souvik-OOPS/SIH-2026/firmware/esp32_health_node/sensor_node.h

#pragma once

#include <DHT.h>
#include <MAX30105.h>

#include "config.h"
#include "telemetry_types.h"

class SensorNode {
 public:
  void begin();
  void update();
  TelemetryData snapshot(bool oledReady) const;

 private:
  void scanI2cBus();
  void beginMax30102();
  void beginMpu6050();
  void updateGas();
  void processPpgSample(uint32_t ir, uint32_t red);
  float readGravityMagnitude(uint8_t address);
  float readGyroMagnitude(uint8_t address);
  bool writeMpuRegisterRetrying(uint8_t address, uint8_t reg, uint8_t value);
  void updatePpg();
  void updateMotion();
  void updateDht22();
  void updateRain();
  void updateSignalQuality(uint32_t irValue);

  MAX30105 _max30102;
  DHT _dht{DHT_DATA_PIN, DHT22};

  bool _max30102Ready = false;
  bool _mpu6050Ready = false;
  uint32_t _lastImuProbeMs = 0;
  float _accelerometerLsbPerG = 4096.0f;
  float _gyroscopeLsbPerDps = 65.5f;
  uint32_t _lastImuMissWarnMs = 0;
  uint8_t _mpu6050Address = 0;
  bool _dht22Ready = false;

  uint32_t _lastPpgReadMs = 0;
  uint32_t _lastIrLogMs = 0;
  uint32_t _lastDhtReadMs = 0;
  uint32_t _lastRainReadMs = 0;
  uint32_t _lastMotionReadMs = 0;
  uint32_t _lastBeatMs = 0;
  uint32_t _lastRateMs = 0;
  uint32_t _lastPpgLogMs = 0;
  float _heartRateBpm = NAN;
  float _spo2Percent = NAN;
  bool _spo2Valid = false;
  bool _fingerPresent = false;
  uint8_t _signalQuality = 0;

  static constexpr uint8_t kSpo2BufferLength = 100;
  uint32_t _irBuffer[kSpo2BufferLength] = {0};
  uint32_t _redBuffer[kSpo2BufferLength] = {0};
  uint8_t _spo2BufferCount = 0;

  float _ambientTemperatureC = NAN;
  float _humidityPercent = NAN;
  float _accelerometerXG = NAN;
  float _accelerometerYG = NAN;
  float _accelerometerZG = NAN;
  float _gyroscopeXDps = NAN;
  float _gyroscopeYDps = NAN;
  float _gyroscopeZDps = NAN;

  /// Raw 12-bit ADC count, kept alongside the percentage so a miscalibrated
  /// board can be diagnosed from telemetry instead of by guesswork.
  int _rainRaw = -1;
  float _rainWetnessPercent = NAN;
  int _gasRaw = -1;
  float _gasIndex = NAN;
  uint32_t _lastGasReadMs = 0;
  uint32_t _lastGasLogMs = 0;
  bool _rainReady = false;
};
