souvik-OOPS/SIH-2026/(commit log)

2026-08-30 Initial commit: SIH26181 privacy-preserving health companion
    ESP32 wearable -> Node backend -> Nuxt 3 PWA prototype for Smart India
    Hackathon 2026 (PS SIH26181, Qualcomm).
    - backend/ Express + Socket.io ingest, rule-based anomaly detection,
    NOAA heat-index stress model, SMS escalation, Postgres/
    in-memory dual store
    - frontend/ Nuxt 3 offline-first PWA dashboard, history and alerts
    - ml/ BIDMC autoencoder training pipeline + JS inference parity test
    - firmware/ ESP32 sensor node with on-device fall detection, plus staged
    t1-t7 bring-up sketches
    - docs/ screenshots and generated README PDF
    Secrets (.env, config.h) are gitignored; .example templ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
    [bidmc_01_Numerics.csv, bidmc_02_Numerics.csv, bidmc_03_Numerics.csv, bidmc_04_Numerics.csv, bidmc_05_Numerics.csv, bidmc_06_Numerics.csv, bidmc_07_Numerics.csv, bidmc_08_Numerics.csv]
2026-09-01 Add Flutter mobile app: telemetry, BLE, SMS escalation, offline assistant
    Days 1-3 of the SIH26181 mobile build, plus the Day 2 BLE firmware and the
    offline AI assistant.
    Mobile app (health-companion/mobile):
    - TelemetrySource abstraction with replay and live-BLE implementations; the
    dashboard depends only on the contract, never on a concrete source.
    - Four deterministic replay fixtures (normal, heat warning, fall +
    non-response, bad signal) so the app demos with no hardware attached.
    - Signal tiers (GOOD/FAIR/POOR/REACQUIRING) and stale-data detection, both
    reported separately from a BLE disconnect.
    - Escalating reconnect backoff (4s -> 60s cap) to replace a fixed-interval
    scan tha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
    [ble_telemetry_service.cpp, ble_telemetry_service.h, buzzer_controller.cpp, buzzer_controller.h, config.example.h, esp32_health_node.ino, oled_status.cpp]
2026-09-01 Flatten repository layout and stop tracking docs
    Moves everything from health-companion/ to the repository root, so backend/,
    frontend/, mobile/, firmware/ and ml/ sit at the top level and README.md is
    the repository's front page. Git recorded these as renames, so file history
    is preserved.
    Stops tracking docs/. It holds generated PDFs and screenshots that are kept
    locally instead of published.
    Two consequences of dropping docs/ from the repository:
    - firmware/esp32_health_node/README.md links to ../../docs/ble_protocol.md.
    The relative path still resolves locally (the directory depth did not
    change), but the target is no longer in the repository, so the link is
    dead for anyone who c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
    [bidmc_01_Numerics.csv, bidmc_02_Numerics.csv, bidmc_03_Numerics.csv, bidmc_04_Numerics.csv, bidmc_05_Numerics.csv, bidmc_06_Numerics.csv, bidmc_07_Numerics.csv, bidmc_08_Numerics.csv]
2026-09-02 Personalise heart-rate rules by age and learned resting baseline
    Adds the two personalisation mechanisms that the dataset can actually support,
    both deterministic. A conditional model over demographics was considered and
    rejected: BIDMC carries no age, sex, height or weight, and 53 subjects cannot
    teach a network what is normal for a cohort without memorising individuals.
    Age tightens the heart-rate ceiling to 70% of Tanaka's maximum
    (208 - 0.7 x age), clamped to 95-140 bpm. Tanaka rather than 220 - age, which
    underestimates maximum heart rate in older adults - the group this project
    targets. Age may only tighten, never raise: a sustained 120 bpm at rest is
    worth flagging at any age, and re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
2026-09-02 Add the offline safety loop: fall detection, risk engine, non-response, packet
    Completes the local pipeline from telemetry to an emergency summary with no
    network involved at any step. Also fills the gap Day 4-6 left: there was no
    risk engine anywhere in the repo, only the placeholder card promising one.
    Fall detection walks a state machine rather than thresholding one spike, since
    a spike alone cannot separate a fall from setting the device down hard:
    free fall (optional) -> impact -> orientation change -> stillness
    Free fall and orientation are corroborating, not required. A fall from sitting
    barely registers free fall, and a wrist-worn device can land oriented much as
    it started, so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
2026-09-02 Add the fall check-in overlay and the privacy screen
    Makes the offline safety loop something a person can drive, rather than
    something only curl could reach. Both screens work with no internet.
    The check-in overlay lives in the layout rather than on the dashboard, so a
    fall surfaces wherever the wearer happens to be looking. It is deliberately
    blocking and full-screen: everything else on this app is information, and this
    is the one thing that asks the wearer to act.
    Its countdown is polled on its own clock rather than driven by incoming
    readings. The whole point of the countdown is the case where the wearer has
    stopped moving and telemetry may have stopped with them, so a timer that only
    a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
2026-09-02 Document the 25 env vars added in Days 7 and 8
    .env.example covered 16 of the 41 variables config.js actually reads, so a
    fresh clone had no way to discover the fall thresholds, the disaster feed
    settings or the alert timings without reading the source.
    Verified that dotenv strips the inline comments: every documented value parses
    to the right type rather than to a string with a comment glued to it.
2026-09-02 Add risk engine, signal-quality rework and the themed dashboard
    This commit carries work from two agents running in parallel on this repo,
    recorded together because the two touched the same files and cannot be
    separated after the fact without a broken intermediate state.
    From Codex: a RiskEngine with its config and tests, a telemetry parser,
    SensorTrustState and FallWorkflowState in the safety assessment, and
    SignalTier reworked into a five-level SignalQualityLevel. The dashboard now
    shows a real risk verdict instead of the "Awaiting Day 4-6 engine"
    placeholder.
    From this session: a theme system in core/theme/app_theme.dart, built from a
    Figma token set designed for a projected demo.
    The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
2026-09-02 Wire the rain board and the two-pin buzzer, and harden the BLE link
    Rain board reads on GPIO 34. The pin is not arbitrary: ADC2, which covers
    GPIO 0, 2, 4, 12-15 and 25-27, shares hardware with the radio and returns
    garbage whenever BLE is active, which for this firmware is always. GPIO 34 sits
    on ADC1 and is input-only, so it also cannot be driven by mistake. Eight
    samples are averaged per read because the ESP32 ADC is noisy, and the front end
    is set to 11 dB so the board's full 0-3.3 V swing is visible rather than
    clipping above ~1.1 V.
    Telemetry carries both the wetness percentage and the raw ADC count. The raw
    count is what makes a fault diagnosable: an unplugged board floats at some
    mi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
    [ble_telemetry_service.cpp, buzzer_controller.cpp, buzzer_controller.h, sensor_node.cpp, sensor_node.h, telemetry_types.h]
2026-09-04 Stop the BLE link killing itself, and identify the IMU by behaviour
    Two BLE bugs, both mine from the Day 3 reconnect work, found by reading
    logcat off the phone rather than by reasoning about the code.
    The link was killing its own connection. _handleDisconnect called
    device.disconnect() on a device that had already dropped. flutter_blue_plus
    queues that request behind a 2 s "disconnect gap", and the queued disconnect
    then tears down the NEXT connection about 1.5 s after it establishes. That
    loops forever: connect, killed, retry, killed. The logs showed it twice with
    near-identical delays of 1458 ms and 1462 ms, which is what gave it away -
    a race would not be that repeatable. Now only a dev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
    [sensor_node.cpp, sensor_node.h]
2026-09-04 Make the pulse sensor detectable, and print the IR count it is judged on
    Heart rate and SpO2 were permanently null with the sensor working. The
    telemetry showed f:0 and q:0 on every packet, which is the firmware correctly
    refusing to invent vitals with no finger detected - so the fault was in
    detection, not in the algorithms.
    Two causes, both starving it.
    LED brightness was 60 of 255, roughly 6 mA of drive. Through a fingertip that
    returns an IR count well under the 50000 contact threshold, so a finger that
    is genuinely present never registers. Raised to 0x7F, which costs battery and
    is what makes contact detectable at all.
    The FIFO averages every four conversions, so its output rate is t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
    [sensor_node.cpp, sensor_node.h]
2026-09-04 Fix the saturated pulse sensor and stop the IMU check failing closed
    Flashing the previous commit and reading the serial output showed both of its
    changes were wrong, in opposite directions.
    The pulse sensor now rails. Raising the LED to 0x7F without raising the
    photodiode range left the count pinned at 262143, the top of the 18-bit ADC.
    A railed signal is flat, and a flat signal has no pulsatile component, so no
    heartbeat can be found in it however long a finger rests there - the same null
    heart rate as before, arrived at from the other side. The ADC range moves to
    16384 to give the brighter LED somewhere to go, and becomes a config value
    since it has to track the brightness. Saturation is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
    [sensor_node.cpp]
2026-09-04 Let the IMU come back without a reflash, and flash at a baud this board survives
    The IMU was probed once, in begin(). A module that was unplugged, or whose
    3V3 rail sagged as the rain board and buzzer were added to it, therefore
    stayed null until the board was reflashed -- so the wiring could be repaired
    with the firmware still reporting nothing, which sends the search into
    software that is working correctly.
    updateMotion() now re-probes every 5 s while no IMU is present, and drops a
    part that stops answering back into probing rather than silently returning
    stale nulls. Reseating a wire is now enough to bring motion back.
    Uploads had failed on every attempt with "Wrong boot mode detected (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
    [sensor_node.cpp, sensor_node.h]
2026-09-04 Stop discarding the computed heart rate, and stop nulling it a line later
    With a finger on the sensor the optical side is healthy - IR reads about
    123000 against a 50000 contact threshold, nowhere near the 262143 rail - and
    yet hr stayed null. Three faults in the same function, each sufficient alone.
    maxim_heart_rate_and_oxygen_saturation() reports a heart rate beside SpO2.
    Both output arguments were passed, filled in, and never read. The rate came
    only from checkForBeat().
    checkForBeat() cannot carry it alone. It accepts a pulse only when the AC
    amplitude falls between 20 and 1000 counts, and through a fingertip at
    MAX30102_LED_BRIGHTNESS 0x7F the swing runs past that ceiling, so every be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
2026-09-04 Stop reporting gravity as movement on the dashboard
    The motion card printed the raw accelerometer magnitude, which is not a
    motion reading. An accelerometer at rest measures one gravity, so a band
    lying perfectly still on a table reported "Motion 1.00 g" - a number that
    reads as movement to anyone looking at it, and never falls to zero however
    still the wearer is.
    Subtract gravity and the figure sits near zero when nothing is happening,
    which is what the card was always meant to convey. The number is still shown
    next to a plain state - Still, Light movement, Active - so the reading stays
    inspectable rather than becoming a bare label.
2026-09-05 Describe movement on the motion card, and stop captioning it with the pulse sensor
    Two faults on the same row.
    It read "Motion -- g". A figure in g is not something anyone reads at a
    glance, and it is the wrong quantity besides: an accelerometer at rest
    measures one gravity, so the number never falls to zero however still the
    wearer is. The row now names what the wearer is doing - Still, Light
    movement, Heavy movement - which is the question the card exists to answer.
    Beside it sat "No finger contact". That is the MAX30102's contact state,
    printed against a reading that comes from the IMU: one sensor's status
    captioning another sensor's measurement, so a perfectly good movement level
    appea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
2026-09-05 Throttle the missing-IMU warning to once every 30 s
    The probe runs every 5 s, and each miss printed a full line. With the IMU
    unplugged the serial log became one sentence repeated twelve times a minute,
    burying the [ppg] and [hr] lines between them - and an unreadable log is how
    the earlier heart-rate faults stayed hidden for as long as they did.
    [sensor_node.cpp, sensor_node.h]
2026-09-05 Filter sensor jitter before scoring, so the model stops calling healthy readings anomalous
    The model was working on paper and failing in practice. JS/numpy parity held
    to 1e-8 and test AUC was 0.807, but fed live demo traffic it flagged 60% of
    readings as anomalous - including HR 73 / SpO2 98, which is textbook normal,
    at 18x the anomaly threshold.
    The cause is a train/serve mismatch in signal smoothness, not in values. In
    the BIDMC numerics the model was trained on, SpO2 is flat between 95.7% of
    consecutive samples and HR between 72.2%, so the autoencoder effectively
    learned that these vitals do not move inside a 30 second window. A real
    MAX30102 and the simulator both emit integers that f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
2026-09-05 Run the learned model on the phone, so it works with no network
    The companion's claim is privacy-preserving monitoring that keeps working
    offline, but the autoencoder only ever ran in the backend and fed the Nuxt
    PWA. The Flutter app - the one being demonstrated - contained no reference to
    it at all and scored risk from rules alone, so the AI half of the pitch was
    not present where anyone would look for it, and it needed a server besides.
    Inference is now a Dart port of anomalyModel.js, reading the same
    assets/ml/model.json. The network is a 4-layer MLP of about 4k parameters, so
    the forward pass is plain arithmetic - no plugin, no native library, no
    download - and 102 KB of weights ship in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
2026-09-05 Stop the model scoring readings the app already distrusts
    Replaying the bundled demo fixtures through the on-device detector showed it
    behaving correctly on three of four, and badly wrong on the fourth:
    normal median ratio 0.08 0/61 past the alert gate
    heat_warning median ratio 9.76 61/61 past it
    fall_nonresponse median ratio 0.49 0/61 (motion event, HR+SpO2 only)
    bad_signal median ratio 191.86 17/17 past it
    bad_signal is not a sick wearer. It is a sensor losing its grip: 7-38%
    confidence, contact flickering on and off, and HR stepping 74 -> 126 -> 49 ->
    151 between consecutive seconds. Scored raw it produced 191x the threshold -
    twenty times lo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
2026-09-05 Clear the model's verdict when it stops having one
    On a live BLE link the card read "Unlike your normal - pattern is 214.2x past
    the learned threshold" while the panel directly above it read "No finger
    contact. Reading unreliable - reacquiring" at 0% signal confidence. The
    loudest alarm the model can raise, sitting above an explicit statement that
    there was no reading behind it. Two faults produced it, both introduced with
    the on-device port.
    The session only assigned a score when one arrived: `if (score != null)`. So
    when the detector correctly declined to score untrustworthy input, the last
    verdict stayed on screen indefinitely - the previous commit stopped the model
    scoring garbage, but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
2026-09-07 Read the MQ-135, and publish it as a gas index rather than an AQI
    Adds the analog gas sensor on ADC1 GPIO 35 - ADC2 is unusable while the radio
    is up, and 34 is already the rain board. Reads average eight conversions every
    two seconds, convert the divider voltage to an Rs/R0 ratio, and invert it into
    a 0-100 relative index.
    The field is named "gas", not "aqi", and that distinction is the point. An
    MQ-135 measures the resistance of one heated tin-dioxide film, driven by CO2,
    ammonia, NOx, benzene, alcohol and smoke together; it cannot separate them and
    it measures no particulates at all. A published AQI figure means a specific
    PM2.5 concentration, so rendering this as AQI would turn an uncal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
    [ble_telemetry_service.cpp, sensor_node.cpp, sensor_node.h, telemetry_types.h]
2026-09-07 Plot the heart-rate trend, and break the line where the sensor lost its grip
    The dashboard showed one instantaneous number, which says nothing about the
    thing a reader actually wants from a vital sign - whether it is climbing,
    settling or holding steady. The PWA has had trend charts since Day 1; the app
    the judges will be looking at had none.
    Hand-painted rather than pulled from a package. The whole figure is a
    polyline, a gradient fill and two labels, in an APK that already carries an
    offline model and an assistant, so a charting dependency would cost more than
    it saves.
    The detail that matters is what happens at a dropout. An untrusted reading is
    recorded as a gap rather than discarded,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
2026-09-07 Drain the pulse FIFO, so the heart rate is computed on the right timebase
    With a finger resting on the sensor and a clean IR reading of 132000, the
    Maxim algorithm reported 93, 166, 115 and 214 bpm from a wearer at rest, with
    SpO2 of 57%. It also ran four times in fifty seconds where it should have run
    about twenty-five. Both symptoms are one fault, and it is not noise.
    updatePpg() took a single sample per 40 ms poll. The loop is blocked for
    roughly half of every second - about 460 ms fragmenting telemetry over BLE at
    20 ms a fragment - so it collected around twelve samples a second rather than
    twenty-five, and every sample the FIFO held meanwhile was discarded. The
    algorithm derives a rate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
    [sensor_node.cpp, sensor_node.h]
2026-09-07 Use the MTU the phone agreed to, and slow the I2C bus to match the wiring
    Two faults found from one observation: the OLED was showing a heart rate that
    the app never displayed. Both read the same TelemetryData fields, so the phone
    was not receiving the packet at all rather than receiving a different value.
    setMTU(185) states only what this device will accept. What is actually in
    force is whatever the phone agreed to, and the sender ignored it entirely -
    fragmenting at a hard-coded 20 bytes, seven of them JSON, so each reading went
    out as two dozen notifications over a link that had already agreed to carry it
    in one. The app discards a whole packet when any fragment is lost or arrives
    out of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
2026-09-07 Scale IMU readings by the range the chip reports, not the one we asked for
    Dropping the bus to 100 kHz brought the IMU back: motion now arrives instead
    of six nulls. It arrives wrong. A board lying still reported az 4.17 g, and
    gravity is 1 g - out by almost exactly four, which is the ratio between the
    +/- 8 g range the code asks for and the +/- 2 g the part powers up in.
    The scale factors were compile-time constants matching the requested ranges,
    so a configuration write that silently failed left the chip at its defaults
    while the arithmetic kept dividing by the requested factor. The result is not
    noise but a clean multiple, and it reads as violent motion from a stationary
    board - the kind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
    [sensor_node.cpp, sensor_node.h]
2026-09-07 Calibrate the IMU scale against gravity, because its range register lies
    Reading the range back was not enough. ACCEL_CONFIG reads as 0x10 - the
    +/- 8 g that was requested - and the code correctly derives 4096 LSB/g from
    it, and the board lying still still reports 4.16 g. The part accepts the range
    write, stores it, returns it on request, and goes on converting at +/- 2 g.
    WHO_AM_I is 0x70, so this is not a real MPU6050 and on these clones the range
    register is decorative.
    Gravity is the one reference always available: a still board measures 1 g
    whatever the silicon claims about itself. The scale is now corrected by the
    nearest power of two - the ratio between adjacent ranges - which turns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
    [sensor_node.cpp, sensor_node.h]
