souvik-OOPS/SIH-2026/(notices)

Notices in the files:
README.md:
License: MIT
